bautsch/keyboard/README.md

# keyboard
# Ortholinear keyboard with normal-sized keys and over-sized knob

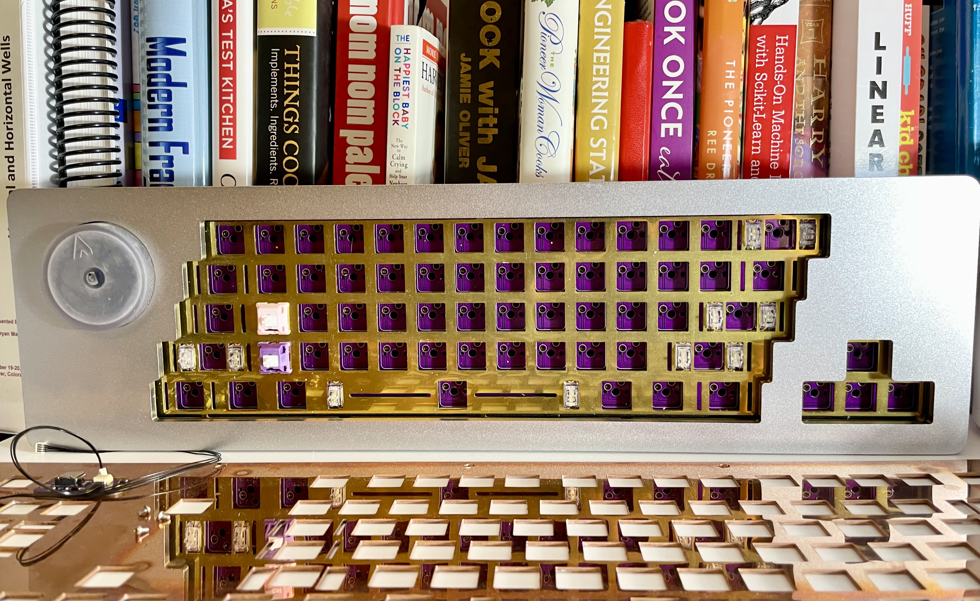
[picture p1: pictures/keyboard.jpeg]
picture of keyboard
