bautsch/keyboard/pictures/t3.jpg

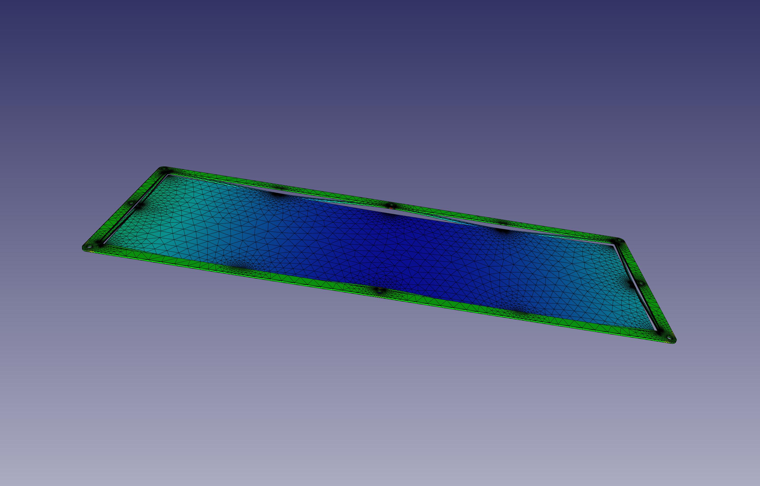
pictures/t3.jpg
