bautsch/keyboard/cad/top_model.step

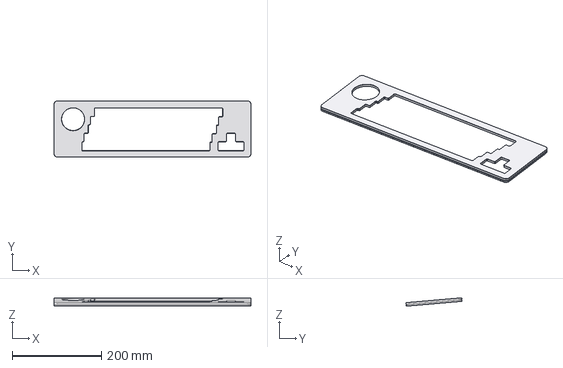
[picture p3: CAD file, 2021-06-21]
cad/top_model.step
441.4 x 125.9 x 19.0 mm
