bautsch/keyboard/cad/weight_model.step

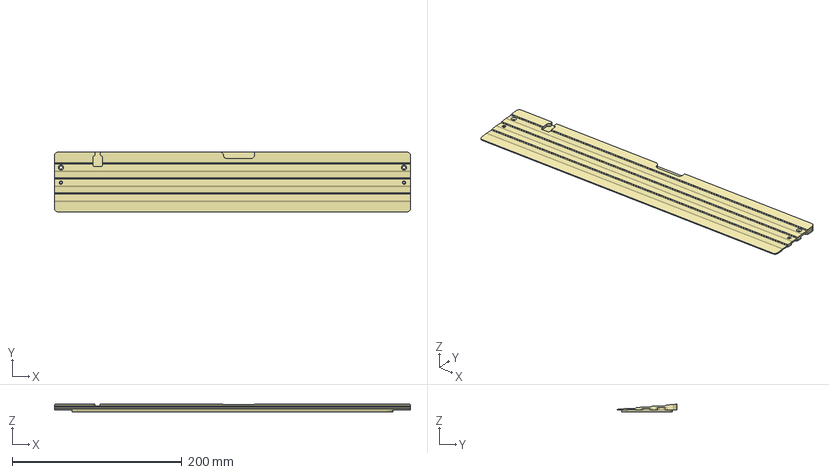
[picture p4: CAD file, 2021-06-21]
cad/weight_model.step
419.2 x 70.5 x 9.23 mm
