bautsch/keyboard/cad/bottom_model.step

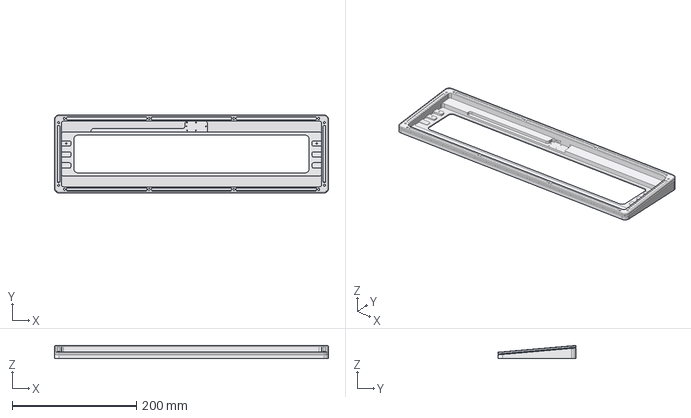
[picture p5: CAD file, 2021-06-21]
cad/bottom_model.step
441.4 x 125.9 x 21.1 mm
