bautsch/keyboard/(list of files, cad)

Other CAD files:
cad/plate.dwg
