bautsch/keyboard/cad/bottom_drawing.pdf

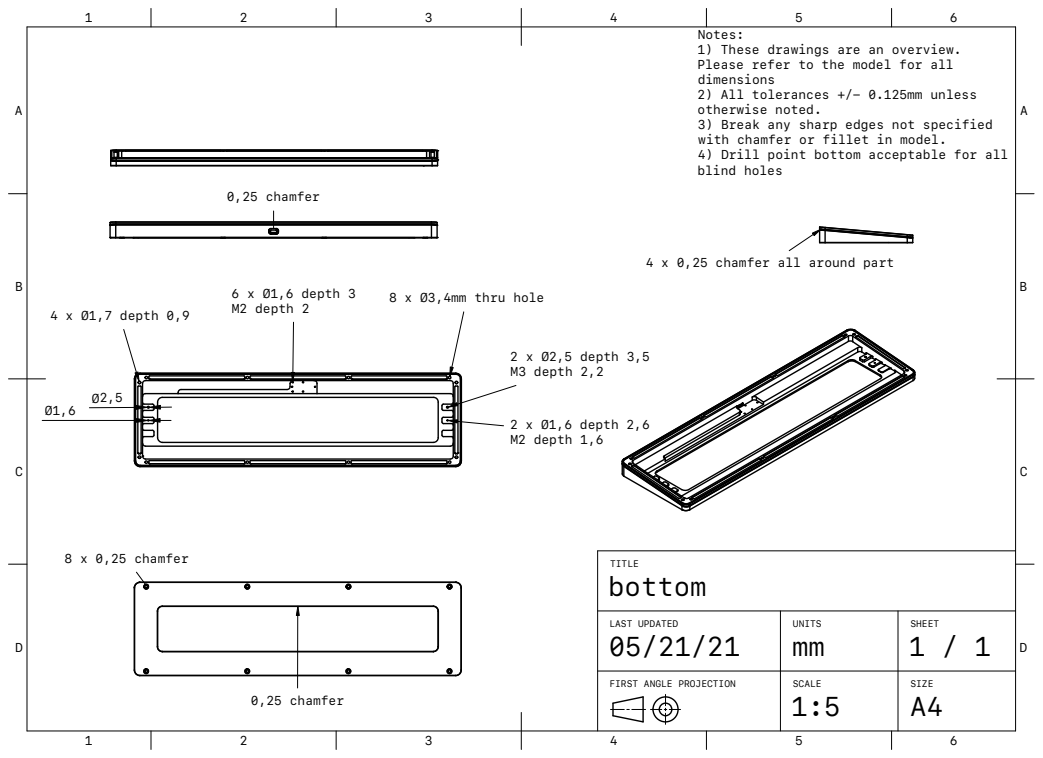
[picture p6: page 1]
8 x Ø3,4mm thru hole; 2 x Ø2,5 depth 3,5 M3 depth 2,2; 2 x Ø1,6 depth 2,6 M2 depth 1,6; 8 x 0,25 chamfer; 6 x Ø1,6 depth 3 M2 depth 2; 0,25 chamfer; 4 x Ø1,7 depth 0,9; TITLE bottom

Notes:
1) These drawings are an overview.
Please refer to the model for all
dimensions
2) All tolerances +/- 0.125mm unless
otherwise noted.
3) Break any sharp edges not specified
with chamfer or fillet in model.
4) Drill point bottom acceptable for all
blind holes

4 x 0,25 chamfer all around part

LAST UPDATED 05/21/21 | UNITS mm | SHEET 1 / 1

FIRST ANGLE PROJECTION | | | SCALE 1:5 | SIZE A4
