bautsch/keyboard/cad/weight_drawing.pdf

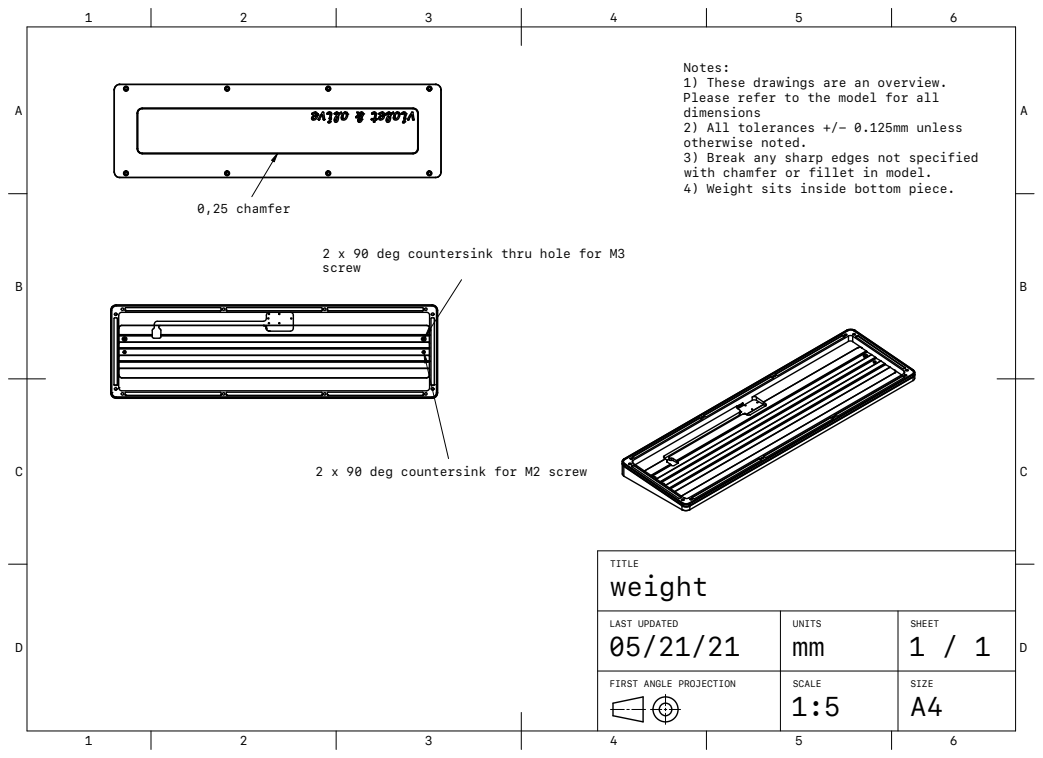
[picture p7: page 1]
0,25 chamfer; TITLE weight

Notes:
1) These drawings are an overview.
Please refer to the model for all
dimensions
2) All tolerances +/- 0.125mm unless
otherwise noted.
3) Break any sharp edges not specified
with chamfer or fillet in model.
4) Weight sits inside bottom piece.

2 x 90 deg countersink thru hole for M3
screw

2 x 90 deg countersink for M2 screw

LAST UPDATED 05/21/21 | UNITS mm | SHEET 1 / 1

FIRST ANGLE PROJECTION | | | SCALE 1:5 | SIZE A4
