bautsch/keyboard/64.kicad_pcb

## KiCad design 64.kicad_pcb (2021-06-21)

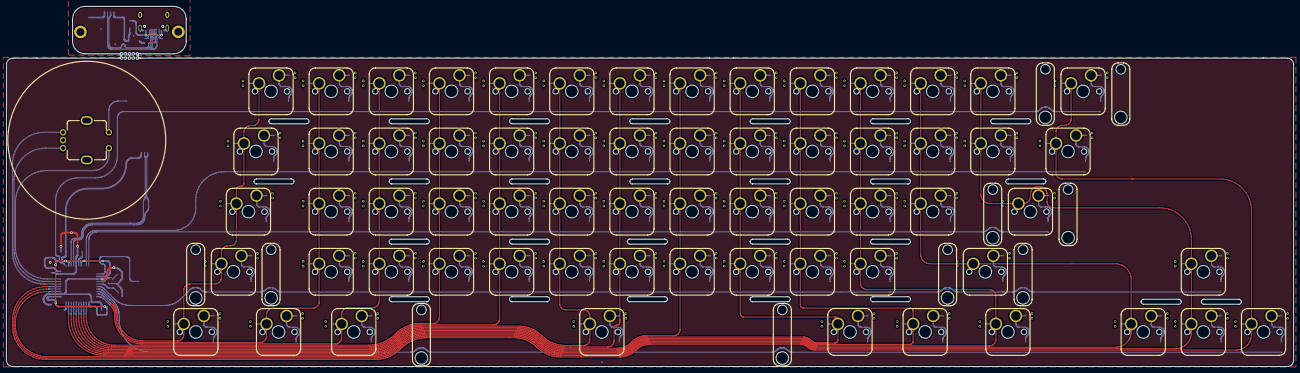
[picture p8: board 64.kicad_pcb from above]

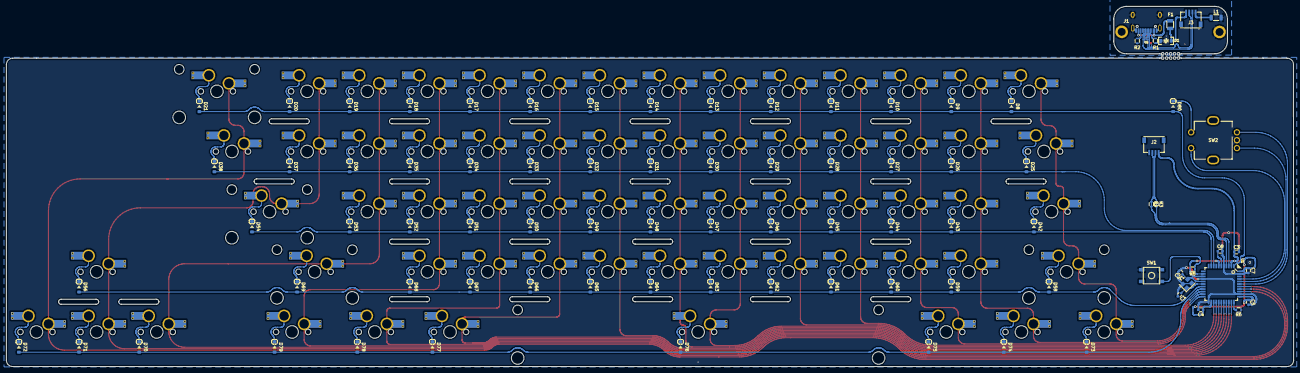
[picture p9: board 64.kicad_pcb from below]

Board: 2 copper layers, 407.6 x 114.0 mm, 157 parts (90 on the bottom side), 100 nets.

Parts:
C1, C2: 22pF; C_0603
C3: 10uF; C_0603
C4, C5, C7: 0.1uF; C_0603
C6: 1uF; C_0603
D1: SMF9.0CA; D_SOD-123_Bidirectional
D8, D9, D10, D11, D12, D13, D14, D15, D16, D17, D18, D19, D20, D21, D25, D26, D27, D28, D29, D30, D31, D32, D33, D34, D35, D36, D37, D38, D42, D43, D44, D45, D46, D47, D48, D49, D50, D51, D52, D53, D54, D56, D58, D59, D60, D61, D62, D63, D64, D65, D66, D67, D68, D69, D70, D71, D72, D73, D74, D75, D76, D77, D78, D79, D80: SOD-123; D_SOD-123
F1: Polyfuse; Fuse_SMD1206_Reflow
J1: TYPE-C-31-M12_13; TYPE-C-31-M-12
J2, J3: SM04B-SRSS-TB(LF)(SN); JST_SM04B-SRSS
L1: 60R@100MHz; L_1206_3216Metric
MH1, MH2: Mount - M2; MountingHole_2.5x4.0mm
MX_#0, MX_#1, MX_#2, MX_#3, MX_#4, MX_#5, MX_#6, MX_#7, MX_#8, MX_#9: MX-1U; MXOnly-1U-NoLED-Hotswap-Antishear
MX_'1: MX-1U; MXOnly-1U-NoLED-Hotswap-Antishear
MX_,1: MX-1U; MXOnly-1U-NoLED-Hotswap-Antishear
MX_-1: MX-1U; MXOnly-1U-NoLED-Hotswap-Antishear
MX_.1: MX-1U; MXOnly-1U-NoLED-Hotswap-Antishear
MX_/1: MX-1U; MXOnly-1U-NoLED-Hotswap-Antishear
MX_;1: MX-1U; MXOnly-1U-NoLED-Hotswap-Antishear
MX_=1: MX-1U; MXOnly-1U-NoLED-Hotswap-Antishear
MX_A1: MX-1U; MXOnly-1U-NoLED-Hotswap-Antishear
MX_B1: MX-1U; MXOnly-1U-NoLED-Hotswap-Antishear
MX_BKSPC1: MX-2U; MXOnly-2U-NoLED-Hotswap-Antishear
MX_C1: MX-1U; MXOnly-1U-NoLED-Hotswap-Antishear
MX_CAPS1: MX-1.75U; MXOnly-1.75U-NoLED-Hotswap-Antishear
MX_D1: MX-1U; MXOnly-1U-NoLED-Hotswap-Antishear
MX_DOWN1: MX-1U; MXOnly-1U-NoLED-Hotswap-Antishear
MX_E1: MX-1U; MXOnly-1U-NoLED-Hotswap-Antishear
MX_ENTER1: MX-2.25U; MXOnly-2.25U-NoLED-Hotswap-Antishear
MX_ESC1: MX-1U; MXOnly-1U-NoLED-Hotswap-Antishear
MX_F1: MX-1U; MXOnly-1U-NoLED-Hotswap-Antishear
MX_G1: MX-1U; MXOnly-1U-NoLED-Hotswap-Antishear
MX_H1: MX-1U; MXOnly-1U-NoLED-Hotswap-Antishear
MX_I1: MX-1U; MXOnly-1U-NoLED-Hotswap-Antishear
MX_J1: MX-1U; MXOnly-1U-NoLED-Hotswap-Antishear
MX_K1: MX-1U; MXOnly-1U-NoLED-Hotswap-Antishear
MX_L1: MX-1U; MXOnly-1U-NoLED-Hotswap-Antishear
MX_LALT1: MX-1.25U; MXOnly-1.25U-NoLED-Hotswap-Antishear
MX_LCODE1: MX-1.25U; MXOnly-1.25U-NoLED-Hotswap-Antishear
MX_LCTRL1: MX-1.5U; MXOnly-1.5U-NoLED-Hotswap-Antishear
MX_LEFT1: MX-1U; MXOnly-1U-NoLED-Hotswap-Antishear
MX_LSHIFT1: MX-2.25U; MXOnly-2.25U-NoLED-Hotswap-Antishear
MX_M1: MX-1U; MXOnly-1U-NoLED-Hotswap-Antishear
MX_N1: MX-1U; MXOnly-1U-NoLED-Hotswap-Antishear
MX_O1: MX-1U; MXOnly-1U-NoLED-Hotswap-Antishear
MX_P1: MX-1U; MXOnly-1U-NoLED-Hotswap-Antishear
MX_Q1: MX-1U; MXOnly-1U-NoLED-Hotswap-Antishear
MX_R1: MX-1U; MXOnly-1U-NoLED-Hotswap-Antishear
MX_RALT1: MX-1.25U; MXOnly-1.25U-NoLED-Hotswap-Antishear
MX_RCODE1: MX-1.25U; MXOnly-1.25U-NoLED-Hotswap-Antishear
MX_RCTRL1: MX-1.5U; MXOnly-1.5U-NoLED-Hotswap-Antishear
MX_RIGHT1: MX-1U; MXOnly-1U-NoLED-Hotswap-Antishear
MX_RSHIFT1: MX-2.75U; MXOnly-2.75U-NoLED-Hotswap-Antishear
MX_S1: MX-1U; MXOnly-1U-NoLED-Hotswap-Antishear
MX_SPACE1: MX-7U; MXOnly-7U-NoLED-Hotswap-Antishear
MX_T1: MX-1U; MXOnly-1U-NoLED-Hotswap-Antishear
MX_TAB1: MX-1.5U; MXOnly-1.5U-NoLED-Hotswap-Antishear
MX_U1: MX-1U; MXOnly-1U-NoLED-Hotswap-Antishear
MX_UP1: MX-1U; MXOnly-1U-NoLED-Hotswap-Antishear
MX_V1: MX-1U; MXOnly-1U-NoLED-Hotswap-Antishear
MX_W1: MX-1U; MXOnly-1U-NoLED-Hotswap-Antishear
MX_X1: MX-1U; MXOnly-1U-NoLED-Hotswap-Antishear
MX_Y1: MX-1U; MXOnly-1U-NoLED-Hotswap-Antishear
MX_Z1: MX-1U; MXOnly-1U-NoLED-Hotswap-Antishear
MX_[1: MX-1U; MXOnly-1U-NoLED-Hotswap-Antishear
MX_\1: MX-1.5U; MXOnly-1.5U-NoLED-Hotswap-Antishear
MX_]1: MX-1U; MXOnly-1U-NoLED-Hotswap-Antishear
R1, R2: 5.1k; R_0603
R3, R4: 22; R_0603
R5: 10k; R_0603
R6: 1k; R_0603
SW1: SW_Push; SKQG-1155865
SW2: Rotary_Encoder_Switch; ALPS_EC11E
U1: ATMEGA32U4; TQPF-44_10x10mm_P0.8mm
U2: TPD4E05U06DQAR; USON-10_2.5x1.0mm_P0.5mm
Y1: 16MHz; Crystal_SMD_3225-4pin_3.2x2.5mm
svg2mod, svg2mod#2: G***; violetta76_main

Connections:
+5V: C3.1, C4.1, C5.1, C7.1, D1.1, F1.1, J2.1, J3.1, R5.2, U1.2, U1.7, U1.14, U1.24, U1.34, U1.44
COL0: SW2.S1, U1.41
COL1: MX_CAPS1.1, MX_ESC1.1, MX_LCTRL1.1, MX_LSHIFT1.1, MX_TAB1.1, U1.20
COL2: MX_#1.1, MX_A1.1, MX_LCODE1.1, MX_Q1.1, MX_Z1.1, U1.21
COL3: MX_#2.1, MX_LALT1.1, MX_S1.1, MX_W1.1, MX_X1.1, U1.22
COL4: MX_#3.1, MX_C1.1, MX_D1.1, MX_E1.1, U1.25
COL5: MX_#4.1, MX_F1.1, MX_R1.1, MX_V1.1, U1.26
COL6: MX_#5.1, MX_B1.1, MX_G1.1, MX_SPACE1.1, MX_T1.1, U1.27
COL7: MX_#6.1, MX_H1.1, MX_N1.1, MX_Y1.1, U1.28
COL8: MX_#7.1, MX_J1.1, MX_M1.1, MX_U1.1, U1.29
COL9: MX_#8.1, MX_,1.1, MX_I1.1, MX_K1.1, MX_RALT1.1, U1.30
COL10: MX_#9.1, MX_.1.1, MX_L1.1, MX_O1.1, MX_RCODE1.1, U1.31
COL11: MX_#0.1, MX_/1.1, MX_;1.1, MX_P1.1, MX_RCTRL1.1, U1.32
COL12: MX_'1.1, MX_-1.1, MX_LEFT1.1, MX_RSHIFT1.1, MX_[1.1, U1.36
COL13: MX_=1.1, MX_DOWN1.1, MX_ENTER1.1, MX_UP1.1, MX_]1.1, U1.37
COL14: MX_BKSPC1.1, MX_RIGHT1.1, MX_\1.1, U1.38
DA+: J1.A6, J1.B6, J2.3, J3.3, R4.1, R4.2, U1.4, U2.1, U2.4, U2.7, U2.10
DA-: J1.A7, J1.B7, J2.2, J3.2, R3.1, R3.2, U1.3, U2.2, U2.5, U2.6, U2.9
EN_A: SW2.A, U1.40
EN_B: SW2.B, U1.39
GND: C1.2, C2.2, C3.2, C4.2, C5.2, C6.2, C7.2, J2.4, J3.4, L1.1, R6.1, SW1.1, SW2.C, U1.5, U1.15, U1.23, U1.35, U1.43, Y1.2, Y1.4
GNDPWR: D1.2, J1.A1, J1.B1, J1.S, L1.2, MH2.1, R1.1, R2.1, U2.3, U2.8
unnamed: C6.1, U1.6
unnamed: D8.1, MX_ESC1.2
unnamed: D9.1, MX_#1.2
unnamed: D10.1, MX_#2.2
unnamed: D11.1, MX_#3.2
unnamed: D12.1, MX_#4.2
unnamed: D13.1, MX_#5.2
unnamed: D14.1, MX_#6.2
unnamed: D15.1, MX_#7.2
unnamed: D16.1, MX_#8.2
unnamed: D17.1, MX_#9.2
unnamed: D18.1, MX_#0.2
unnamed: D19.1, MX_-1.2
unnamed: D20.1, MX_=1.2
unnamed: D21.1, MX_BKSPC1.2
unnamed: D25.1, MX_TAB1.2
unnamed: D26.1, MX_Q1.2
unnamed: D27.1, MX_W1.2
unnamed: D28.1, MX_E1.2
unnamed: D29.1, MX_R1.2
unnamed: D30.1, MX_T1.2
unnamed: D31.1, MX_Y1.2
unnamed: D32.1, MX_U1.2
unnamed: D33.1, MX_I1.2
unnamed: D34.1, MX_O1.2
unnamed: D35.1, MX_P1.2
unnamed: D36.1, MX_[1.2
unnamed: D37.1, MX_]1.2
unnamed: D38.1, MX_\1.2
unnamed: D42.1, MX_CAPS1.2
unnamed: D43.1, MX_A1.2
unnamed: D44.1, MX_S1.2
unnamed: D45.1, MX_D1.2
unnamed: D46.1, MX_F1.2
unnamed: D47.1, MX_G1.2
unnamed: D48.1, MX_H1.2
unnamed: D49.1, MX_J1.2
unnamed: D50.1, MX_K1.2
unnamed: D51.1, MX_L1.2
unnamed: D52.1, MX_;1.2
unnamed: D53.1, MX_'1.2
unnamed: D54.1, MX_ENTER1.2
unnamed: D56.1, MX_UP1.2
unnamed: D58.1, MX_LSHIFT1.2
unnamed: D59.1, MX_Z1.2
unnamed: D60.1, MX_X1.2
unnamed: D61.1, MX_C1.2
unnamed: D62.1, MX_V1.2
unnamed: D63.1, MX_B1.2
unnamed: D64.1, MX_N1.2
unnamed: D65.1, MX_M1.2
unnamed: D66.1, MX_,1.2
unnamed: D67.1, MX_.1.2
unnamed: D68.1, MX_/1.2
unnamed: D69.1, MX_RSHIFT1.2
unnamed: D70.1, MX_LEFT1.2
unnamed: D71.1, MX_DOWN1.2
unnamed: D72.1, MX_RIGHT1.2
unnamed: D73.1, MX_LCTRL1.2
unnamed: D74.1, MX_LCODE1.2
unnamed: D75.1, MX_LALT1.2
unnamed: D76.1, MX_SPACE1.2
unnamed: D77.1, MX_RALT1.2
unnamed: D78.1, MX_RCODE1.2
unnamed: D79.1, MX_RCTRL1.2
unnamed: D80.1, SW2.S2
unnamed: J1.A5, R1.2
unnamed: J1.B5, R2.2
unnamed: R5.1, SW1.2, U1.13
unnamed: R6.2, U1.33
ROW0: D8.2, D9.2, D10.2, D11.2, D12.2, D13.2, D14.2, D15.2, D16.2, D17.2, D18.2, D19.2, D20.2, D21.2, D80.2, U1.1
ROW1: D25.2, D26.2, D27.2, D28.2, D29.2, D30.2, D31.2, D32.2, D33.2, D34.2, D35.2, D36.2, D37.2, D38.2, U1.9
ROW2: D42.2, D43.2, D44.2, D45.2, D46.2, D47.2, D48.2, D49.2, D50.2, D51.2, D52.2, D53.2, D54.2, U1.10
ROW3: D56.2, D58.2, D59.2, D60.2, D61.2, D62.2, D63.2, D64.2, D65.2, D66.2, D67.2, D68.2, D69.2, U1.18
ROW4: D70.2, D71.2, D72.2, D73.2, D74.2, D75.2, D76.2, D77.2, D78.2, D79.2, U1.19
VBUS: F1.2, J1.A4, J1.B4
XTAL1: C1.1, U1.17, Y1.1
XTAL2: C2.1, U1.16, Y1.3
